Yverr0y/rf-directional-tracker/Directional Tracking Videos + Photos/2 Node Setup.jpg

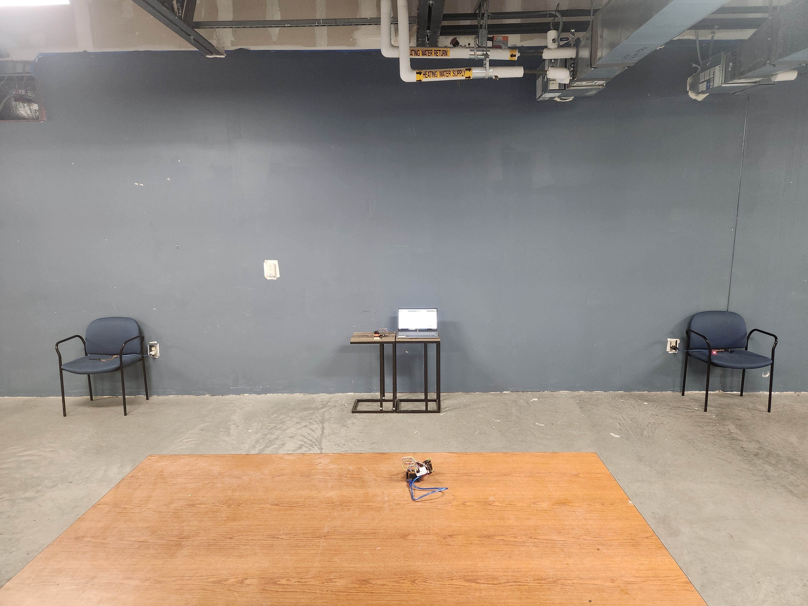
Directional Tracking Videos + Photos/2 Node Setup.jpg
