Yverr0y/rf-directional-tracker/Directional Tracking Videos + Photos/Three Node Setup.jpg

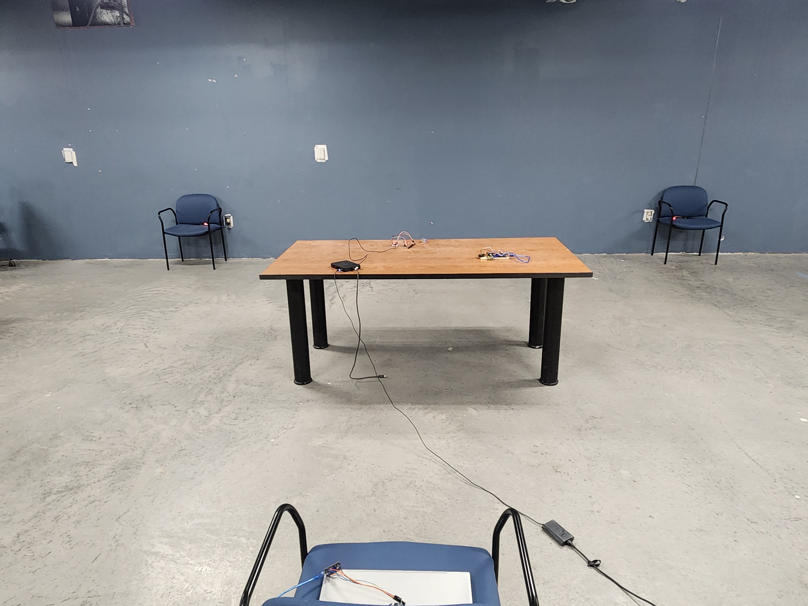
Directional Tracking Videos + Photos/Three Node Setup.jpg
