Yverr0y/rf-directional-tracker/Directional Tracking Videos + Photos/Brain Node with Servo.jpg

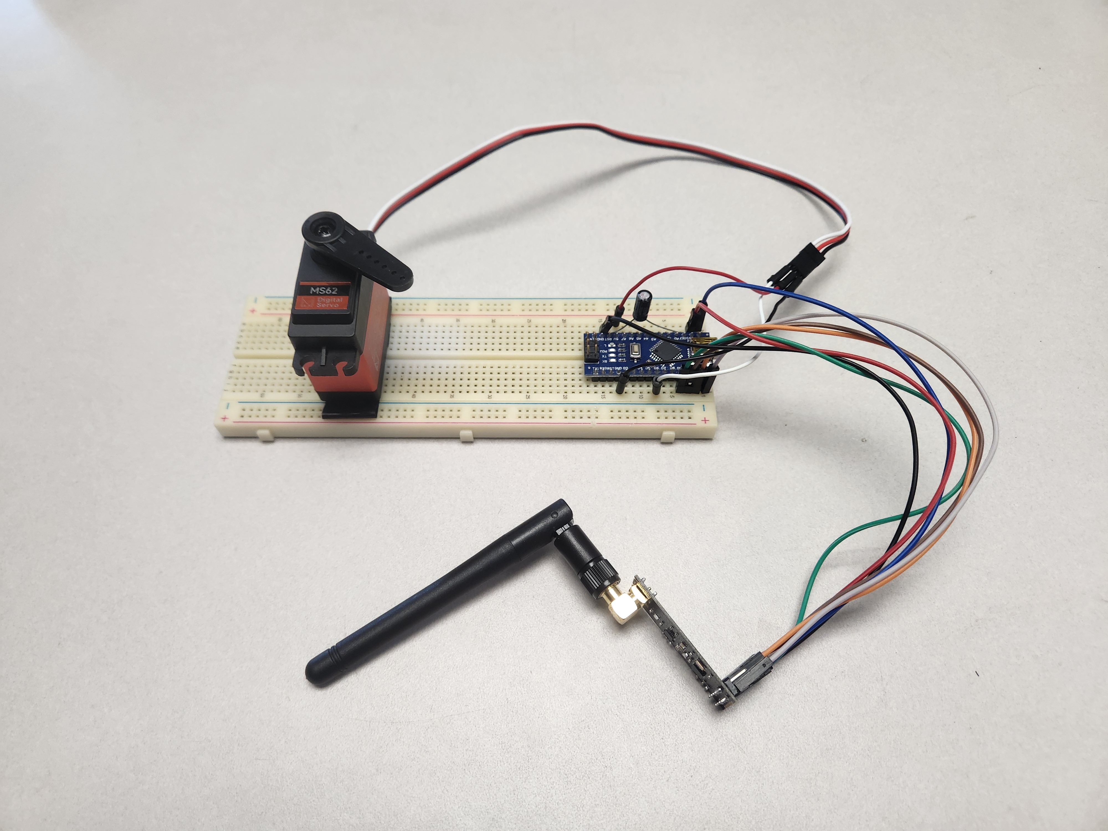
Directional Tracking Videos + Photos/Brain Node with Servo.jpg
