Yverr0y/rf-directional-tracker/Directional Tracking Videos + Photos/Node Transceiver.jpg

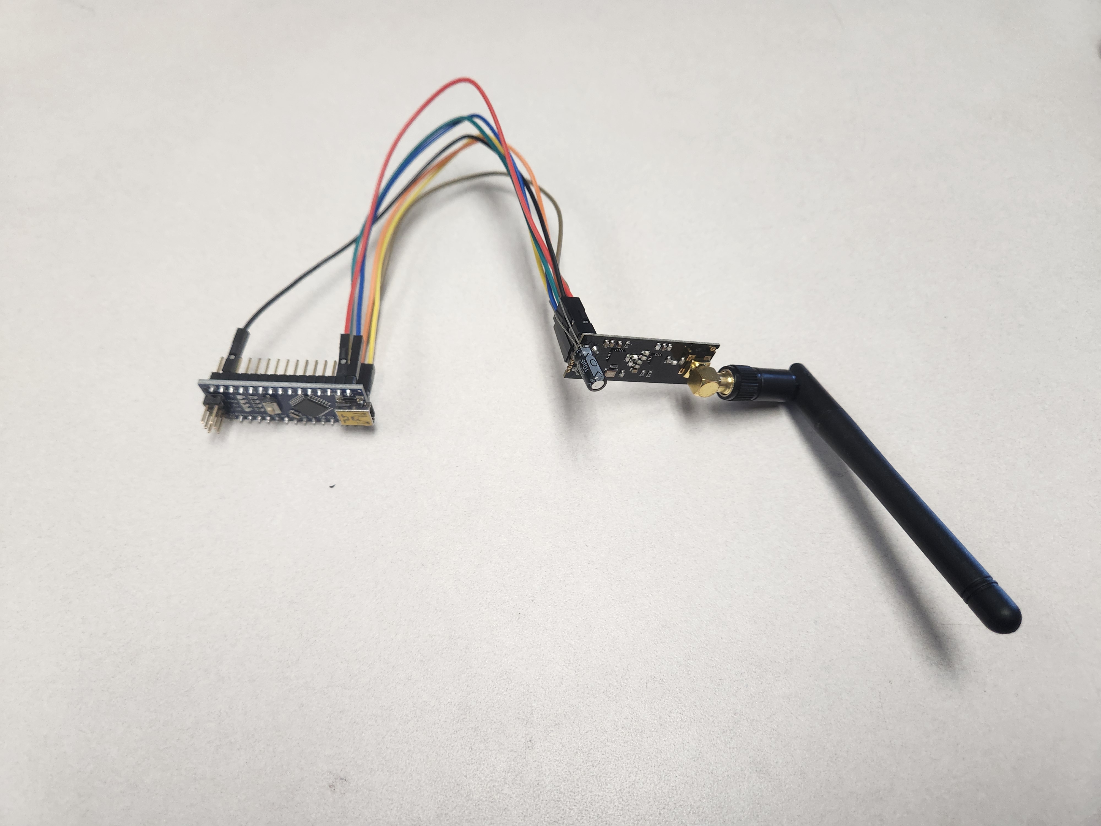
Directional Tracking Videos + Photos/Node Transceiver.jpg
