Yverr0y/rf-directional-tracker/Directional Tracking Videos + Photos/Uno Transitter.jpg

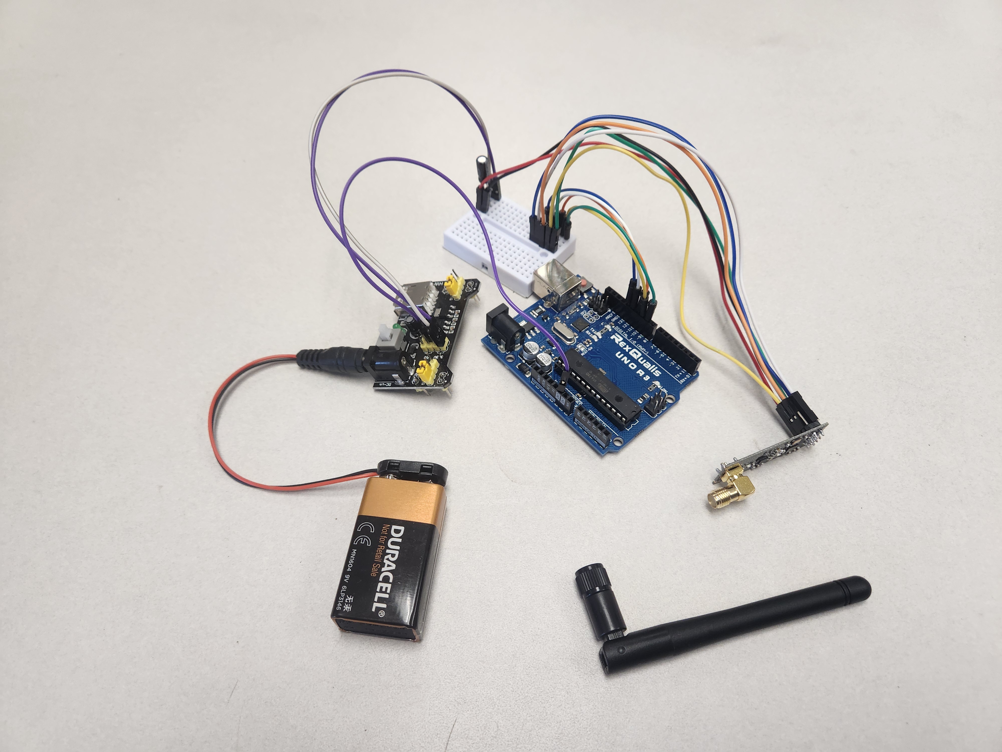
Directional Tracking Videos + Photos/Uno Transitter.jpg
