Yverr0y/rf-directional-tracker/(commit log)

2026-06-07 Initial commit with current scripts for receiver and transmitter showing functionality
2026-07-01 Analog RSSi with MK-RM-5V receivers has too high of a noise floor/signal range is not high enough. Adding 17.3cm antennas did not resolve the issue. Switching to NRF24L01 for a proper RSSI register
    [receivesignal.ino, transmitsignal.ino]
2026-07-04 NRF24l01 transmitter working;had to use external 3.3V power supply (HW-131); disasbled auto-ack to transmit successfully without a receiver confirming message was sent
2026-07-04 RSSI proxy via NRF24L01 packet/ping counting successfully manipulated 360 degree servo: stopped on strong signal, moved slowed on a medium signal, and moves faster on a weaker signal. Moving forward 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
2026-07-04 Discovered Arduino Nano 3.3V is sufficient for transmitting signals unlike Arduino Uno. Enables Nano's to both receiver and transmit signal without needing external power supply like the Uno.
2026-07-05 Brain Node receives data briefly but then fails, issue seems to stem from how the hardware related issues and potential RF collisions. Switching to using a polling method to deconflict the nodes.
    [Brain_Node.ino, Node2_Receiver.ino]
2026-07-05 Resolved timing issues by having Nodes pause listening for indefinitely until the Brain node's request, and by deconflicting transmitter channel with the Node's channels for transmission. Brain relia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
    [Brain_Node.ino, Node1_Receiver.ino, Node2_Receiver.ino, receivesignal.ino, transmitsignal.ino]
2026-07-06 Completed tracking using two receivers; can reliably track an incoming transmission on a 180 degree plane. Performed RSSI squaring to amplify differential for better servo direction given proximity o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
2026-07-07 Uploaded pictures aand video for completed Stage 2 illustrating servo movement towards direction transmitter moves to.
2026-07-12 Evaluated dual core approach with ESP32 as Brain and Node3. Led to many timing issues due to the sharing of SPI buses (servo/stepper motor attached to other SPI bus; didn't make a digital SPI due to 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
    [Brain_Node.ino, Node3_Receiver.ino]
2026-07-13 Implmented third receiver node, placing the three nodes in an equilateral triangle, successfully rotates stepper towards location of RF signal in 360 degrees. Added poll verification on the nodes to 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
    [Brain_Node.ino, Node1_Receiver.ino, Node2_Receiver.ino, Node3_Receiver.ino]
2026-07-13 Changing smoothing average to Kalman filter to reduce fluctuation lag and help reduce unpredictability of RSSI count (more stable when transmitter is close, less stable when transmitter is farther aw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
2026-07-15 Successfully tested three nodes for 360 degree tracking. Improved Kalman filter to adapt based on distance as RSSI values fluctuate more when the transmitter is far away vs when it's close to a node.
2026-08-28 Decided to continue this project by adding an additional transmitter. Initial code for the Brain node and Node1 receiver such that two transmitters can be tracked. Removing stepper motor from code.
