Yverr0y/rf-directional-tracker/Directional Tracking Videos + Photos/Brain Node with Stepper.jpg

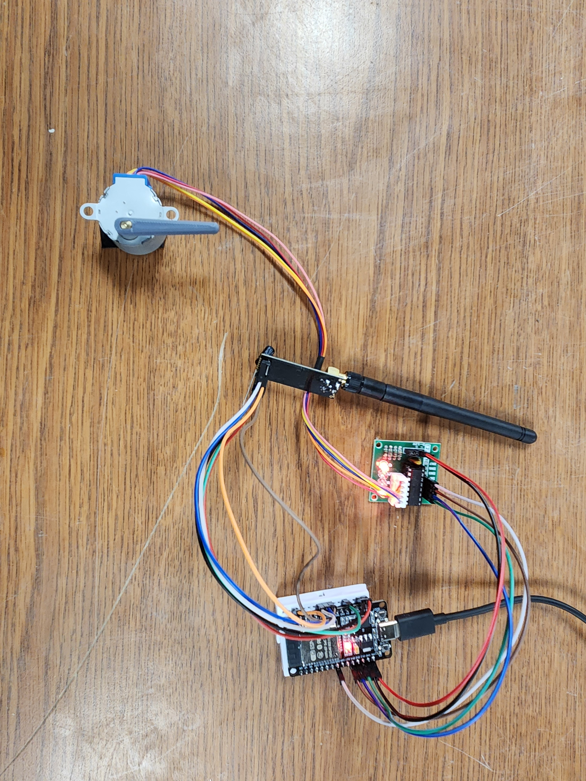
Directional Tracking Videos + Photos/Brain Node with Stepper.jpg
